elektryk763/Tasmociag_z_segregacja_elementow_belka_tesno/schemat.png

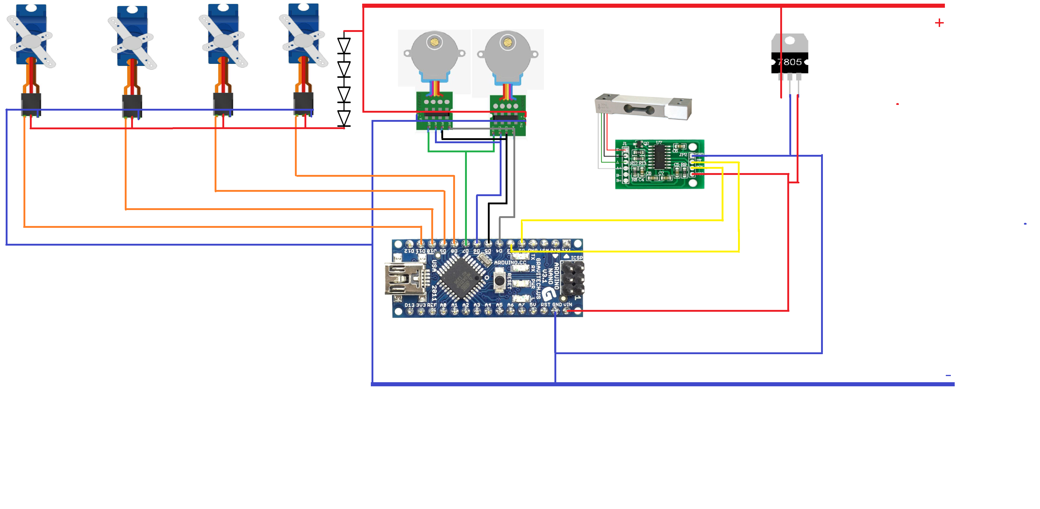
schemat.png
